tejashah88/TechShop-tank/README.md

# TechShop-tank
An arduino project for controlling a mini tank with Bluetooth. (WIP)
