tejashah88/TechShop-tank/TechShop Tank Schematic.pdf

## Appendix A: Full Schematic

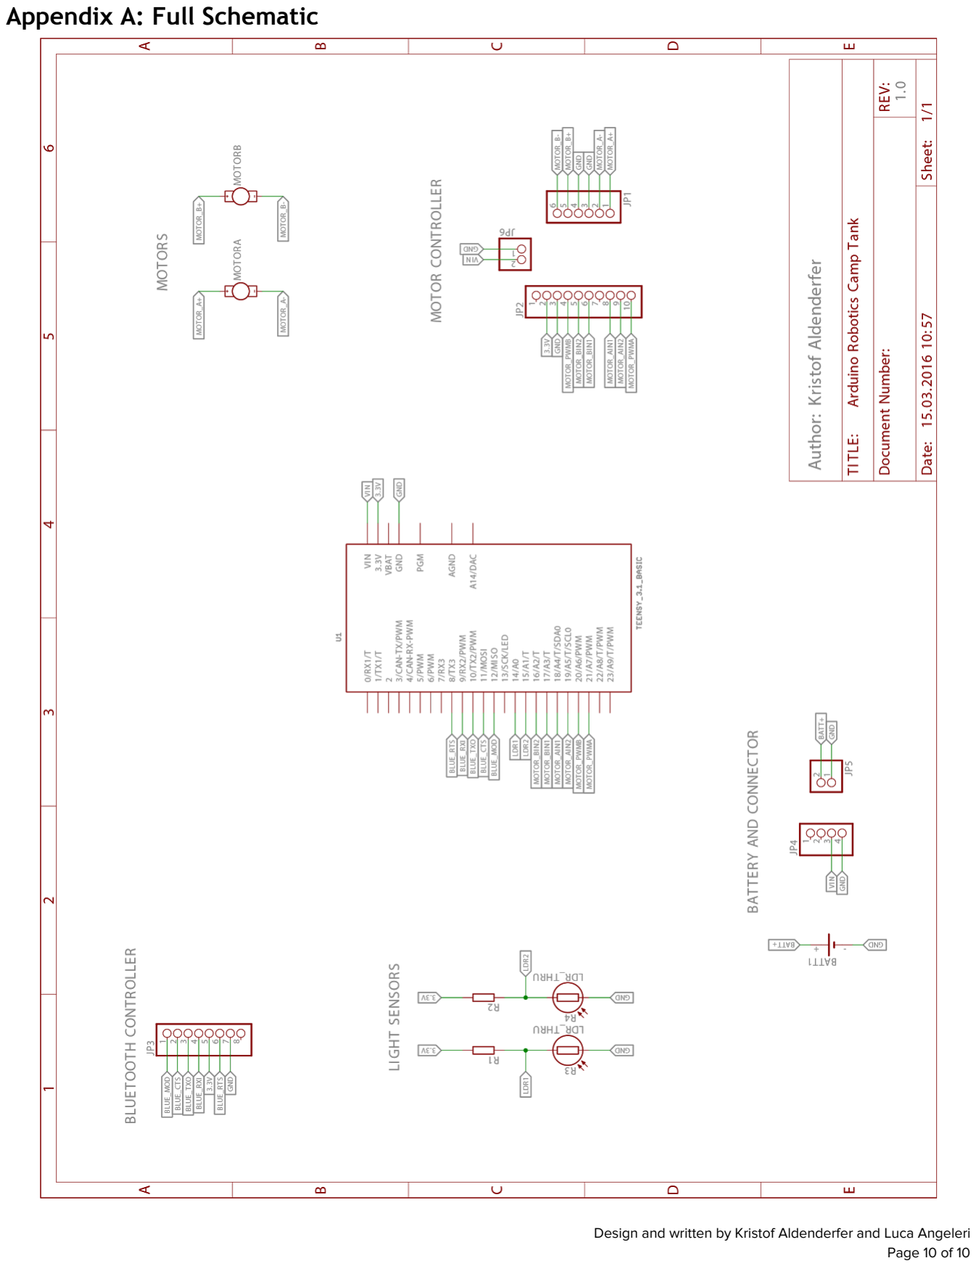
[picture p1: page 1]

Design and written by Kristof Aldenderfer and Luca Angeleri
